Lyniat/Alchemistry/README.md

# Alchemistry

## A project for the Arduino Micro

Alchemistry is a project for the Arduino Micro, where you can combine different
Elements to create new ones.

Every element bottle has an RFID chip, which is needed to seperate the different elements in the code. 

## License

##### by Laurin Muth and Christoph Härtl

<br />This work is licensed under a <a rel="license" href="http://creativecommons.org/licenses/by-nc-sa/4.0/">Creative Commons Attribution-NonCommercial-ShareAlike 4.0 International License</a>.
